SebDE/TOS-100/README.md

# TOS-100
TMC260 Stepper Driver Arduino Shield
