SebDE/TOS-100/gerber/README.rtf

tmc-260-shield.gbl - bottom copper
tmc-260-shield.gbo - bottom silk
tmc-260-shield.gbs - bottom solder mask
tmc-260-shield.gtl - top copper
tmc-260-shield.gto - top silk
tmc-260-shield.gts - top solder mask
tmc-260-shield.txt - drill

Bottom Layers are not mirrored (see copper fill vs dimension)
