SebDE/TOS-100/TMC 260 Shield BOM.pdf

Part # | # | Manufact # /Spec
IC1 | 1 | TMC260-PA
R1,2 | 2 | 10Ω, 0603
R3,4 | 2 | 0,15Ω, 2512 - 1W
R7, 9,11,13 | 4 | 10k, 0603
R6,10,12,8,14 | 5 | 560Ω, 0603
R16,17,18 | 4 | 100k, 0603
R15 | 1 | 1k, 0603
C1,2
C1‘, C2‘
C3,4,5,7,8,9,10 | 7 | 1µF,50V, 0603
C6 | 1 | 4,7µF - 10µF, 50V 1206
PWR, EN | 1 | OSRAM Micro Sideled Green
STEP, DIR | 2 | OSRAM Micro SideLed Yellow
SG | 1 | OSRAM Micro SideLED Red
Reset | 1 | Panasonic EVQ-Q2K03W
T1-5 | 4 | BC850CW, NPN BEC; SOT-323
Q1 | 1 | BC856BW PNP BEC, SOT-323
J1 | 1 | 2,1mm DC Barrel
hd_bottom | 2 | 8-pos stackable header, nicht bestückt
hd_top | 2 | 6-pos stackable Header, nicht bestückt
JP1
2 | Elko Panasonic G, 50V, EEEFC1H470P / EEEFK1H221P
2 | alternativ zu C1,C2: 50V, 20-50µF, 3,5mm Rastermass, max 10mm Durchmesser
1 | 4pos Molex KK horiz, 4pos 3,5mm screw header, nicht bestückt
