SebDE/TOS-100/pdf/tmc-260-shield.pdf

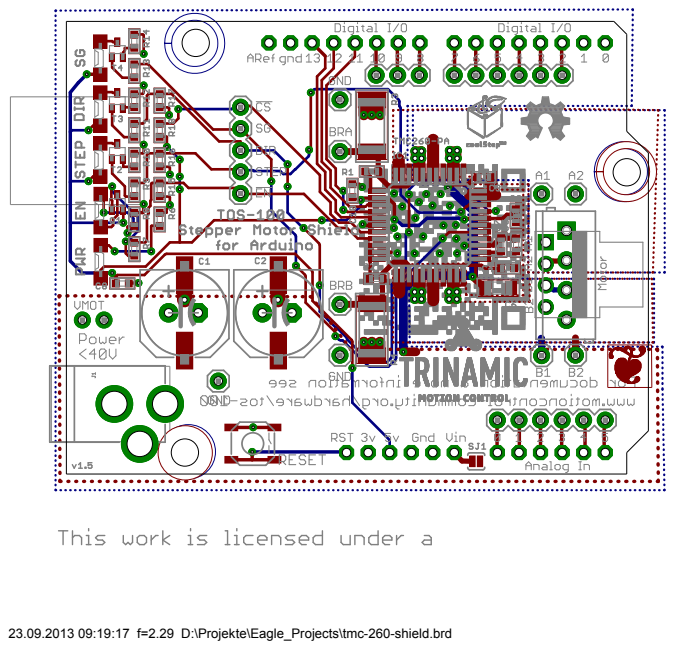
[picture p10: page 1]

23.09.2013 09:19:17 f=2.29 D:\Projekte\Eagle_Projects\tmc-260-shield.brd
