SebDE/TOS-100/pdf/tmc-260-shield.placement.pdf

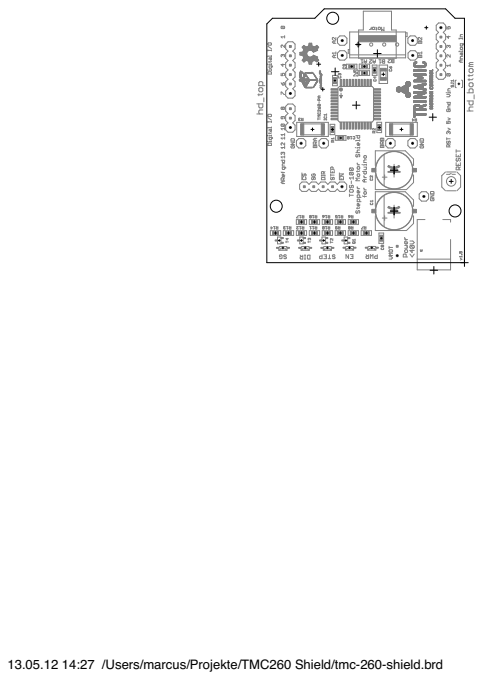
[picture p11: page 1]

13.05.12 14:27 /Users/marcus/Projekte/TMC260 Shield/tmc-260-shield.brd
