SebDE/TOS-100/pdf/tmc-260-shield.silk-bottom.pdf

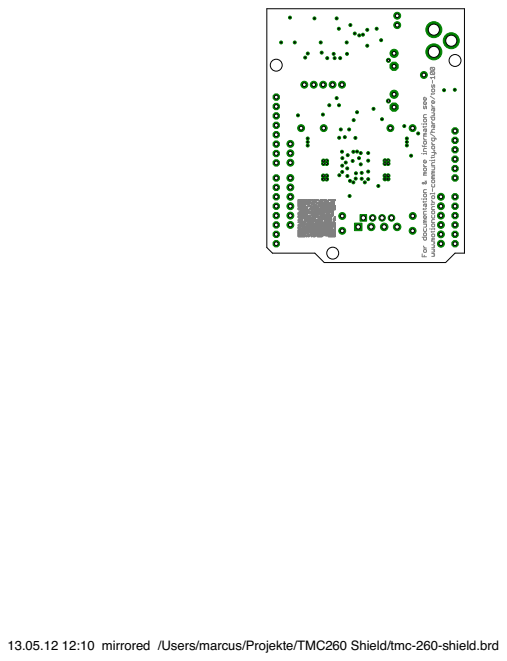
[picture p12: page 1]

13.05.12 12:10 mirrored /Users/marcus/Projekte/TMC260 Shield/tmc-260-shield.brd
