SebDE/TOS-100/pdf/tmc-260-shield.silk-top.pdf

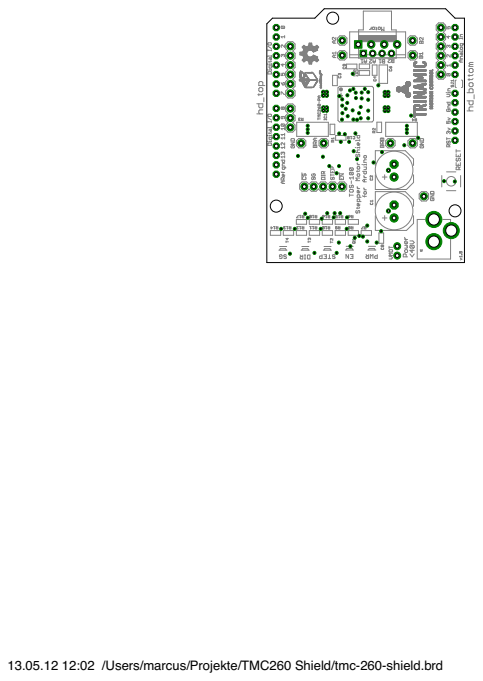
[picture p13: page 1]

13.05.12 12:02 /Users/marcus/Projekte/TMC260 Shield/tmc-260-shield.brd
