SebDE/TOS-100/eagle/tmc-260-shield.brd

## EAGLE design eagle/tmc-260-shield.brd (2015-08-26)

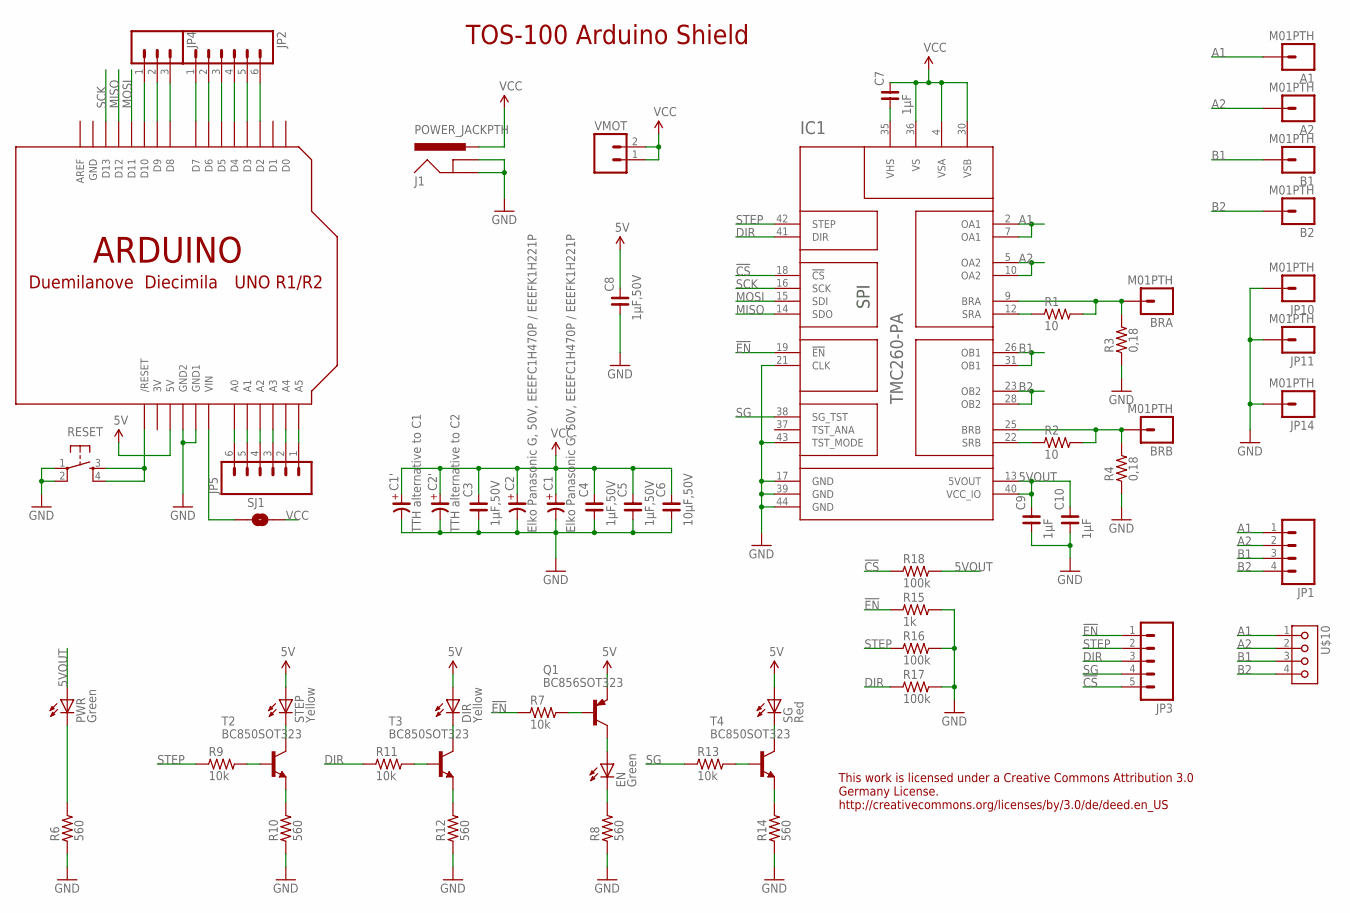
[picture p14: schematic tmc-260-shield.sch]

Parts:
A1, A2: M01PTH; 1X01
B1, B2: M01PTH; 1X01
BRA: M01PTH; 1X01
BRB: M01PTH; 1X01
C1, C2: Elko Panasonic G, 50V, EEEFC1H470P / EEEFK1H221P; CSV-G
C1': TTH alternative to C1; CE-035X100
C2': TTH alternative to C2; CE-035X100
C3, C4, C5, C8: 1µF,50V; C0603
C6: 10µF,50V; C1206
C7, C9, C10: 1µF; C0603
DIR: Yellow; MICRO-SIDELED
EN: Green; MICRO-SIDELED
IC1: TMC260-PA; PQFP44_WITH_PADS
J1: POWER_JACKPTH; POWER_JACK_PTH
JP1: M04SCREW; SCREWTERMINAL-3.5MM-4
JP2, JP5: M06SIP; 1X06
JP3: M05PTH; 1X05
JP4: M03PTH; 1X03
JP10, JP11, JP14: M01PTH; 1X01
PWR: Green; MICRO-SIDELED
Q1: BC856SOT323; SOT323-BEC
R1, R2: 10; R0603
R3, R4: 0,18; R2512
R6, R8, R10, R12, R14: 560; R0603
R7, R9, R11, R13: 10k; R0603
R15: 1k; R0603
R16, R17, R18: 100k; R0603
RESET: TAC_SWITCHSMD; TACTILE_SWITCH_SMD
SG: Red; MICRO-SIDELED
SJ1: SOLDERJUMPERNO; SJ_2S-NO
STEP: Yellow; MICRO-SIDELED
T2, T3, T4: BC850SOT323; SOT323-BEC
U$1: ARDUINOUNO; ARDUINO
U$10: KK4H; KK-H-4
VMOT: M021X02_NO_SILK; 1X02_NO_SILK

Connections:
3V: U$1.3V
5V: C8.2, DIR.A, Q1.E, SG.A, STEP.A, U$1.5V
5VOUT: C9.2, C10.2, IC1.13 (5VOUT), IC1.40 (VCC_IO), PWR.A, R18.2
!CS: IC1.18 (!CS), JP3.5, R18.1
!EN: IC1.19 (!EN), JP3.1, R7.1, R15.1
A1: A1.1, IC1.2 (OA1), IC1.7 (OA1), JP1.1, U$10.1
A2: A2.1, IC1.5 (OA2), IC1.10 (OA2), JP1.2, U$10.2
B1: B1.1, IC1.26 (OB1), IC1.31 (OB1), JP1.3, U$10.3
B2: B2.1, IC1.23 (OB2), IC1.28 (OB2), JP1.4, U$10.4
DIR: IC1.41 (DIR), JP3.3, R11.1, R17.1
GND: C1.-, C1'.-, C2.-, C2'.-, C3.1, C4.1, C5.1, C6.1, C8.1, C9.1, C10.1, IC1.17 (GND), IC1.21 (CLK), IC1.39 (GND), IC1.43 (TST_MODE), IC1.44 (GND), J1.GND, J1.GNDBREAK, JP10.1, JP11.1, JP14.1, R3.1, R4.1, R6.1, R8.1, R10.1, R12.1, R14.1, R15.2, R16.2, R17.2, RESET.1, RESET.2, U$1.GND, U$1.GND1, U$1.GND2
MISO: IC1.14 (SDO), U$1.D12
MOSI: IC1.15 (SDI), U$1.D11
unnamed: JP4.1, U$1.D10
unnamed: JP4.2, U$1.D9
unnamed: JP4.3, U$1.D8
unnamed: JP2.1, U$1.D7
unnamed: JP2.2, U$1.D6
unnamed: JP2.3, U$1.D5
unnamed: JP2.4, U$1.D4
unnamed: JP2.5, U$1.D3
unnamed: JP2.6, U$1.D2
unnamed: JP5.1, U$1.A5
unnamed: JP5.2, U$1.A4
unnamed: JP5.3, U$1.A3
unnamed: JP5.4, U$1.A2
unnamed: JP5.5, U$1.A1
unnamed: JP5.6, U$1.A0
unnamed: R9.2, T2.B
unnamed: RESET.3, RESET.4, U$1.RESET (/RESET)
unnamed: SJ1.1, U$1.VIN
unnamed: STEP.C, T2.C
unnamed: R10.2, T2.E
unnamed: PWR.C, R6.2
unnamed: R11.2, T3.B
unnamed: DIR.C, T3.C
unnamed: R12.2, T3.E
unnamed: EN.A, Q1.C
unnamed: BRA.1, IC1.9 (BRA), R1.2, R3.2
unnamed: IC1.12 (SRA), R1.1
unnamed: BRB.1, IC1.25 (BRB), R2.2, R4.2
unnamed: IC1.22 (SRB), R2.1
unnamed: EN.C, R8.2
unnamed: Q1.B, R7.2
unnamed: R13.2, T4.B
unnamed: SG.C, T4.C
unnamed: R14.2, T4.E
SCK: IC1.16 (SCK), U$1.D13
SG: IC1.38 (SG_TST), JP3.4, R13.1
STEP: IC1.42 (STEP), JP3.2, R9.1, R16.1
VCC: C1.+, C1'.+, C2.+, C2'.+, C3.2, C4.2, C5.2, C6.2, C7.2, IC1.4 (VSA), IC1.30 (VSB), IC1.36 (VS), J1.PWR, SJ1.2, VMOT.1, VMOT.2
VHS: C7.1, IC1.35 (VHS)

Notes on the sheet:
TOS-100 Arduino Shield
This work is licensed under a Creative Commons Attribution 3.0 Germany License. http://creativecommons.org/licenses/by/3.0/de/deed.en_US

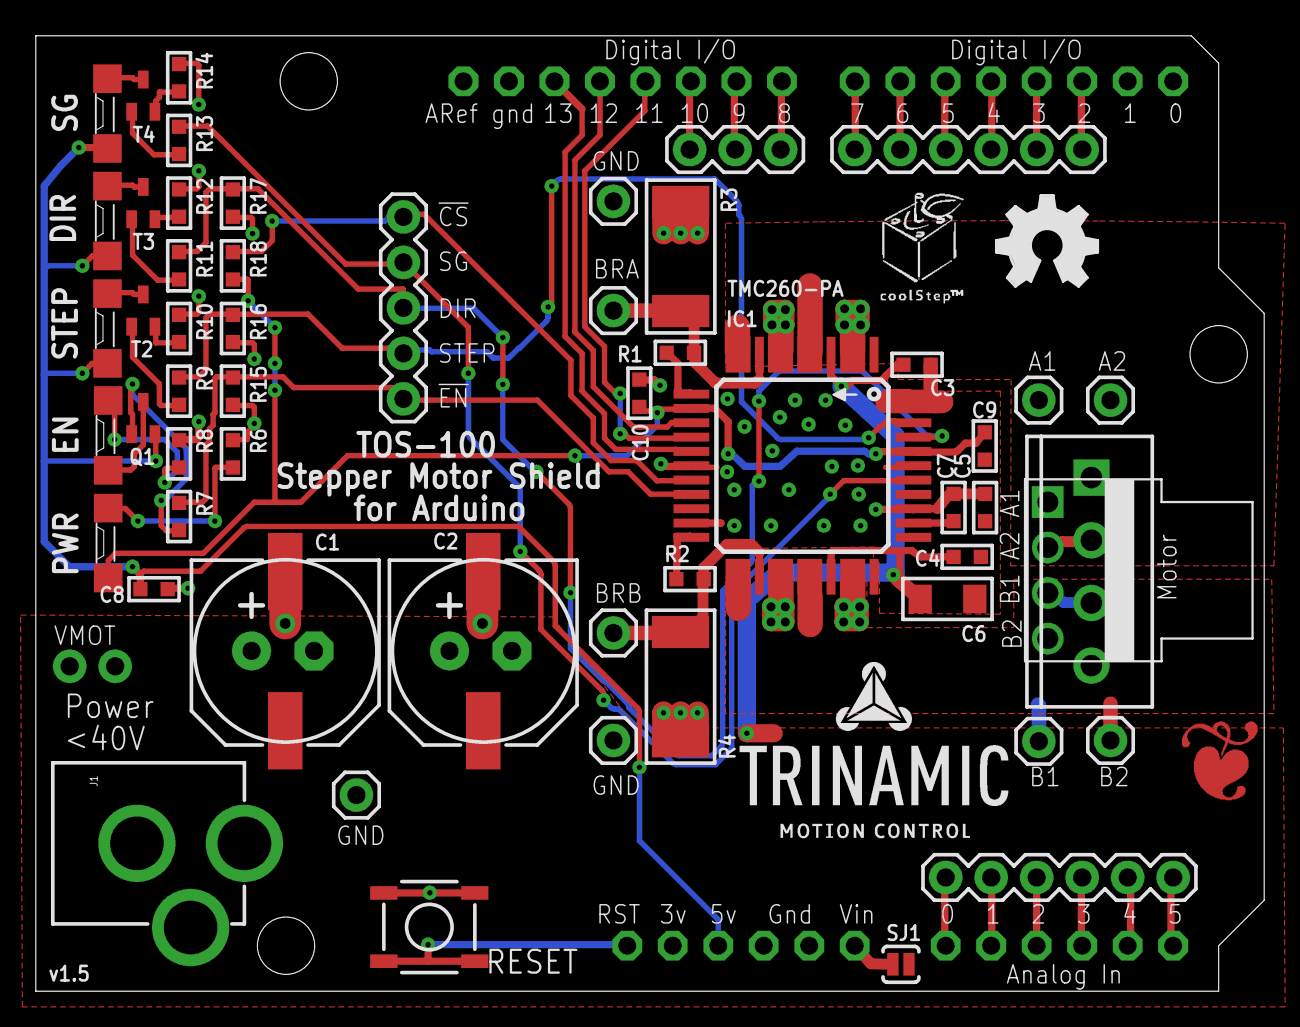
[picture p15: board tmc-260-shield.brd from above]

Board: 2 copper layers, 68.6 x 53.3 mm, 64 parts (0 on the bottom side), 51 nets.

Other parts of the board:
U$5: LOGO
U$9: COOLSTEP
U$11: OSHW_FILLX200_NOTEXT
U$12: SMALL_LOGO_COPPER
U$13: QR-TMC-100-BOTTOM-BIG
